valenparamero-crypto/M.A.V.I/diseño mecánico/README.md

# 🔧 Diseño Mecánico — M.A.V.I.

*Módulo Autónomo de Visión Inteligente*

Esta carpeta contiene la documentación del diseño estructural, el modelado CAD tridimensional optimizado, los registros de prototipado rápido y los archivos estandarizados para la fabricación del chasis y los acoples de M.A.V.I.

---

## 📁 Estructura del Área

```text
diseño mecánico/
├── CAD/                                  # Modelos tridimensionales y versiones de diseño
│   ├── v1_inicial/                       # Historial de versiones preliminares
│   │   └── chasis_mavi.stp
│   └── chasis_mavi_modelo_integral_v2.step # Modelo CAD consolidado actual
├── Evidencias/                           # Renders 3D, galería visual y registros de manufactura
│   ├── README.md
│   ├── chasis_mdf_pruebas_fisicas.png
│   ├── proceso_impresion_3d.png
│   ├── soporte_motores.png
│   ├── soportes_rueda_loca_impresos.png
│   ├── vista_isometrica_inferior.png
│   ├── vista_isometrica_superior.png
│   └── DISEÑO CONCEPTUAL CAD CON LISTADO DE MATERIALES.pdf
└── README.md                             # Documentación principal del área
```

---

## ⚙️ Características Mecánicas y de Manufactura

* **Optimización de Chasis:** Reubicación espacial de la batería y rediseño de la distribución interna para mejorar el centro de masa y la estabilidad del robot.
* **Fabricación Aditiva (SLA/FDM):** Impresión 3D en resina y polímeros para soportes personalizados de motorreductores y ruedas locas de balín.
* **Prototipado Físico:** Mecanizado de chasis en MDF para pruebas piloto de validación geométrica, tolerancias y ensamble mecánico preliminar.
* **Sistemas de Tracción:** Acoples adaptados para la integración de ruedas Mecanum orientadas a locomoción omnidireccional.

---

## 👤 Responsables

**Sara Edith Perilla** — Rol: Mecánica  

Formación Integral · Proyecto Integrador I · Proyecto Integrador II · Ingeniería Mecatrónica · Universidad Tecnológica de Pereira · 2026-2
