valenparamero-crypto/M.A.V.I/documentación/README.md

# 📄 Documentación — M.A.V.I.

> *Módulo Autónomo de Visión Inteligente*

Esta carpeta centraliza la documentación formal del proyecto M.A.V.I. Contiene la formulación técnica, la planificación de actividades, los registros de bitácoras y el presupuesto detallado elaborado bajo las normas APA 7ma edición.

---

## 📁 Estructura y Contenido de la Carpeta

```text
documentación/
├── ACTA DE CONSTITUCIÓN.pdf                        # Documento base y acta de inicio del proyecto
├── BITÁCORA DE PLANEACIÓN SEMANA 10 Y 11.pdf         # Planeación de actividades técnicas y administrativas (Semanas 10 y 11)
├── BITÁCORA DE PLANEACIÓN SEMANA 12-13-14.pdf      # Planeación estratégica para las semanas 12 a 14
├── GANTT.xlsx                                      # Cronograma detallado y estimación de carga horaria
├── PLANEACIÓN BITÁCORA SEMANA 8 Y 9.pdf              # Registro preliminar de planeación (Semanas 8 y 9)
├── PLANEACIÓN Y EJECUCIÓN BITÁCORA SEMANA 8 Y 9.pdf  # Bitácora consolidada de planeación y ejecución (Semanas 8 y 9)
├── PLANEACIÓN Y EJECUCIÓN BITÁCORA SEMANA 10 Y 11.pdf  # Bitácora consolidada de planeación y ejecución (Semanas 10 y 11)
├── PROPUESTA FORMAL.pdf                            # Propuesta técnica formal del sistema autónomo
├── README.md                                       # Índice y presentación de la carpeta de documentación
└── Ruta_Critica_CPM.png                            # Diagrama CPM de precedencias, ruta crítica activa y holguras
```  

---

## 👤 Responsable

**Laura Valentina Paramero Lopez** — *Rol: Documentación*  

*Formación Integral · Proyecto Integrador I · Proyecto Integrador II*  
*Ingeniería Mecatrónica · Universidad Tecnológica de Pereira · 2026-2*
