valenparamero-crypto/M.A.V.I/diseño electrónico/Diagrama_De_Bloques_Electrónico.png

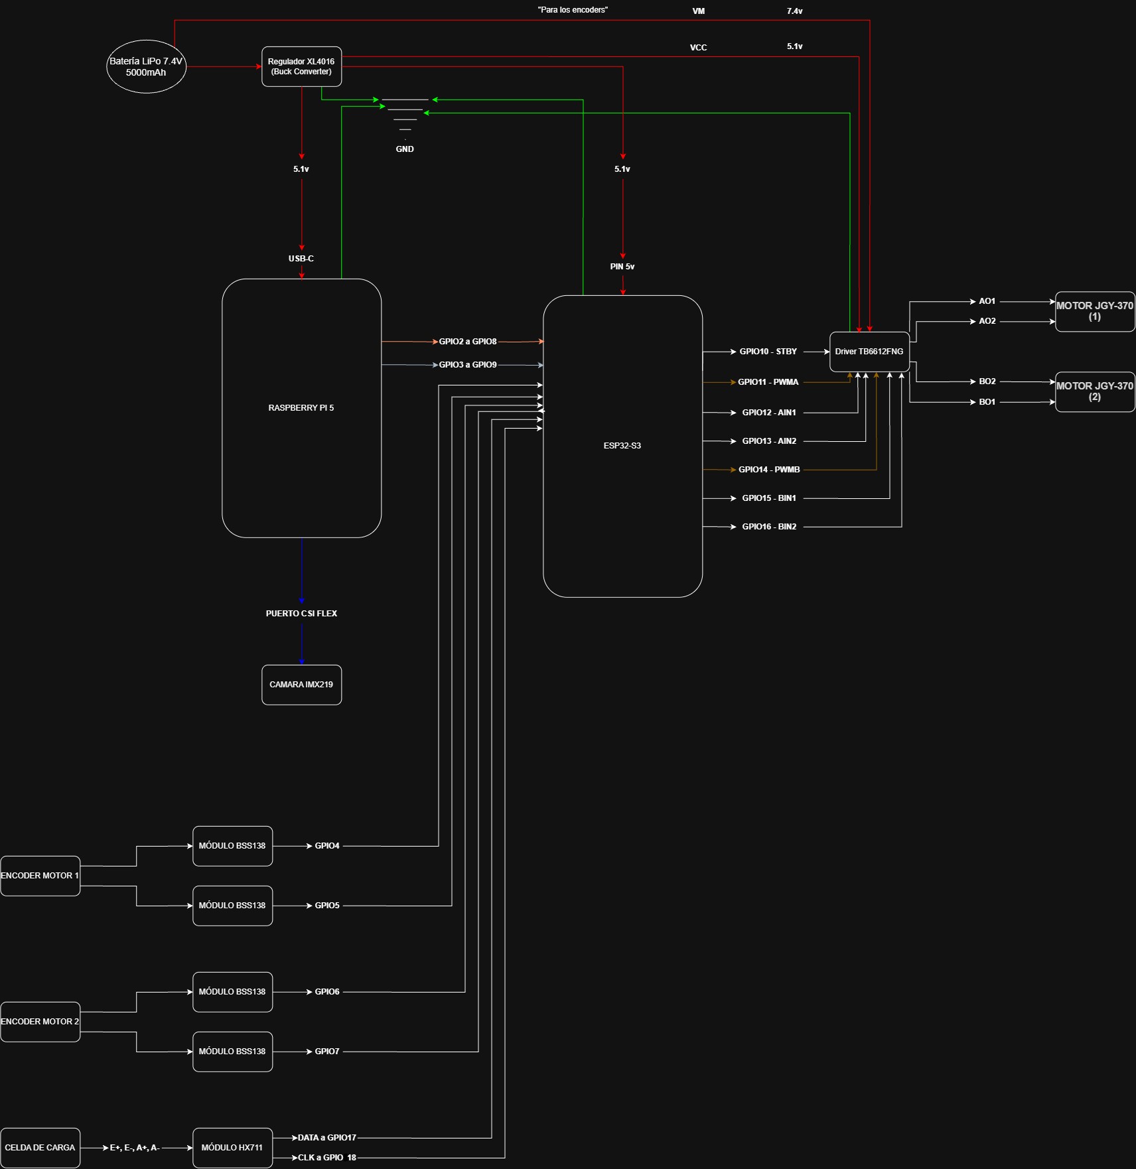
diseño electrónico/Diagrama_De_Bloques_Electrónico.png
