valenparamero-crypto/M.A.V.I/documentación/Ruta_Critica_CPM.png

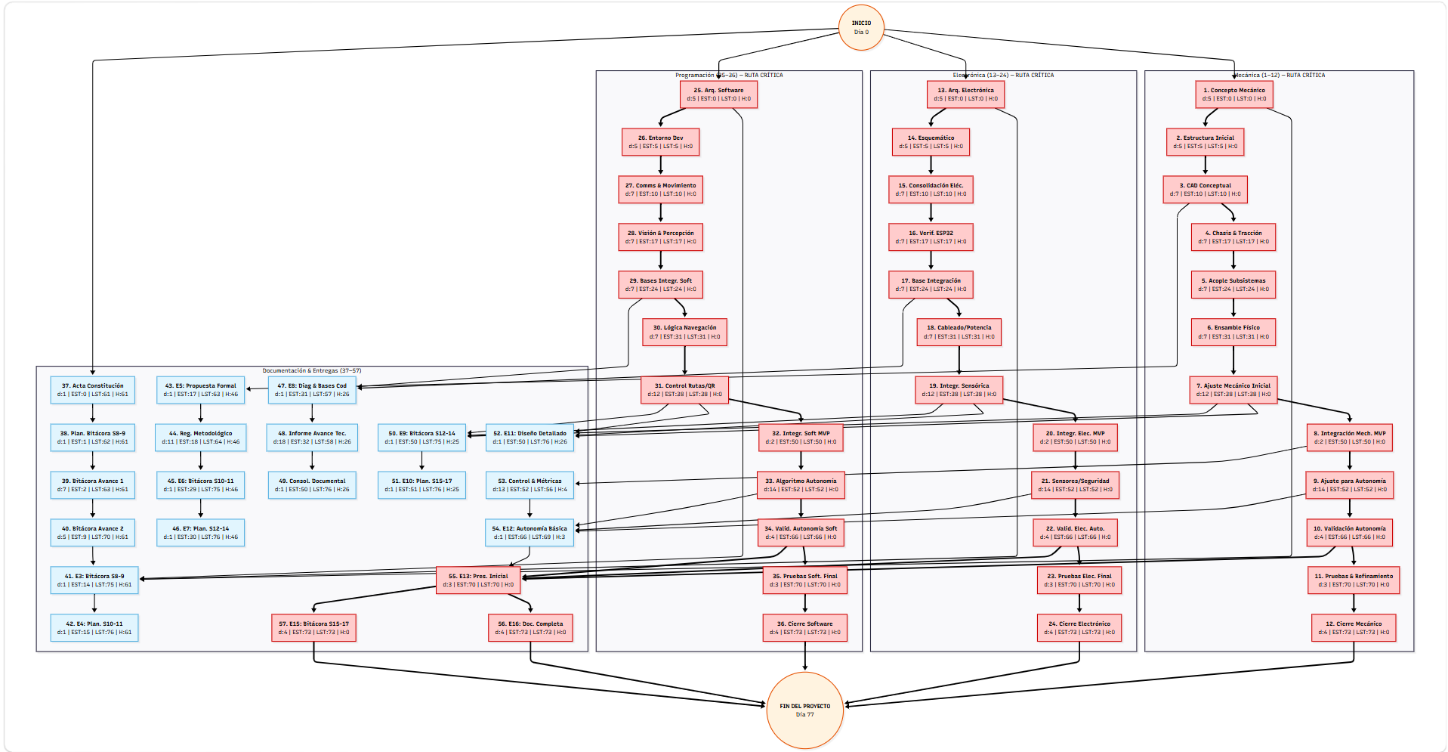
documentación/Ruta_Critica_CPM.png
