valenparamero-crypto/M.A.V.I/diseño mecánico/CAD/chasis_mavi_modelo_integral_v2.step

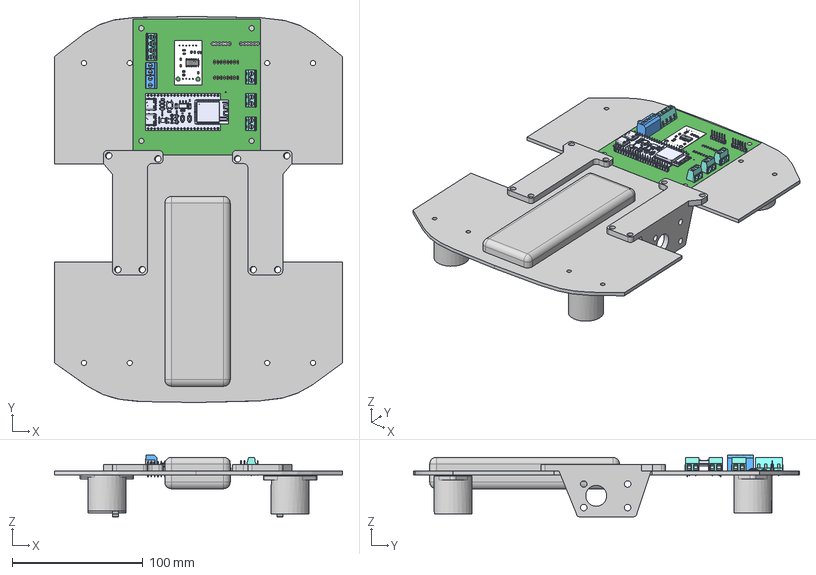
[picture p30: CAD file, 2026-10-15]
diseño mecánico/CAD/chasis_mavi_modelo_integral_v2.step
220.0 x 294.8 x 47.0 mm
BATERIA LiPo TURNIGY 7.4V 5000mAh
