valenparamero-crypto/M.A.V.I/(list of files, cad)

Other CAD files:
diseño mecánico/CAD/v1_inicial/chasis_mavi.stp
diseño electrónico/PCB/mavi_pcb_diseno_integral.f3z
