valenparamero-crypto/M.A.V.I/diseño mecánico/DISEÑO CONCEPTUAL CAD CON LISTADO DE MATERIALES.pdf

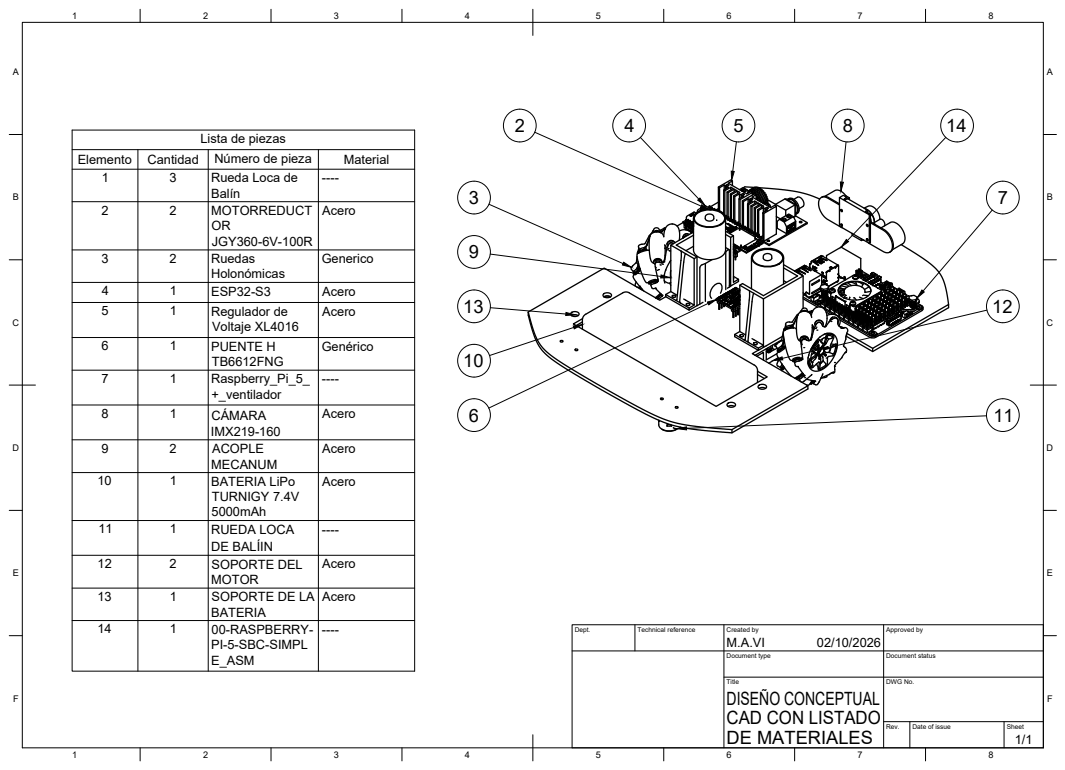
[picture p31: page 1]
Dept.; Technical reference; Created by; Approved by; Document type; Document status; Title; DWG No.; Rev.; Date of issue; Sheet; Elemento; Cantidad; Número de pieza; Material; Rueda Loca de; MOTORREDUCT; Regulador de; Voltaje XL4016; PUENTE H; CÁMARA; BATERIA LiPo; TURNIGY 7.4V; RUEDA LOCA; DE BALÍIN; SOPORTE DEL; SOPORTE DE LA

Lista de piezas

PI-5-SBC-SIMPL
E_ASM

DISEÑO CONCEPTUAL
CAD CON LISTADO
DE MATERIALES
