valenparamero-crypto/M.A.V.I/(commit log)

2026-09-09 Creación de la carpeta de diseño electrónico y de su respectivo README
2026-09-09 Creación de la carpeta de diseño mecánico y de su respectivo README
2026-09-09 Creación de la carpeta de diseño documentación y de su respectivo README
2026-09-10 Actualización del RD de programación
2026-09-10 Actualización del RD de M.A.V.I
2026-09-16 docs: agrega acta de constitución, gantt y ruta crítica
    [GANTT.xlsx]
2026-09-16 Actualización del Readme principal y Readme de documentación
2026-09-16 Cambio de tabla por guia tipo estructura y actualiza nombre completoen Readme de documentación
2026-09-17 Agregar bitácora de planeación semana 8 y 9, actualizacion del RD principal y actualización del RD de documentación
2026-09-25 Crear estructura inicial de src (raspberry, esp32, common)
2026-09-27 Agregar protocol.py con armado y verificacion de mensajes I2C
2026-09-27 Agregar bus I2C simulado y script de prueba del protocolo
2026-09-27 Unificar formato de mensajes en bus_falso
2026-09-27 Agregar acceso real al bus I2C (pendiente de probar con hardware)
2026-09-27 Actualización de RD de M.A.V.I, de src, de common y de raspberry
2026-10-01 Actualización de RD de src
2026-10-01 docs: modularizar README de diseño electronico y crear galeria en evidencias
2026-10-01 corregir nombres de archivos png y enlaces de evidencias
2026-10-01 agregar archivo del chasis en diseño mecanico
    [chasis_mavi.stp]
2026-10-01 Crear carpeta de evidencias y su respectivo rd
2026-10-01 Actualizar rd de diseño mecanico y diseño electronico
2026-10-01 Actualizar evidencias de diseño electrónico
2026-10-01 Actualizar rd de diseño electrónico
2026-10-01 Actualizar rd de documentaciín y agregar bitácora de planeación semana 10 y 11
2026-10-01 Subir documento de planeación y ejecución semana 8 y 9, y actualización de rd de documentación
2026-10-01 Corregir rd de documentación
2026-10-02 Añadir diagrama de bloques y actualizar rd de diseño electrónico
2026-10-03 Agregar diseño cad con lista de materiales
2026-10-15 Actualizar rd de varias carpetas, subir evidenicias
    [chasis_mavi.stp, chasis_mavi_modelo_integral_v2.step, mavi_pcb_diseno_integral.f3z]
2026-10-15 Actualizar rd de documentación y del principal, agregar bitacora de planeación y ejecución semana 10 y 11
2026-10-16 Actualizar rd de evidencias de diseño electronico
2026-10-16 Actualizar rd de diseño electronico
2026-10-16 Agregar en src programa de funcionamiento basico de la camara
2026-10-16 Actualizar rd de la carpeta rpi
2026-10-28 Add files via upload
    Código de avance en la RPI que contiene reconocimiento de AprilTags, Comunicación I2C con ESP32-S3, Telemetría básica RPM, Reconocimiento temprano de pista y Reconocimiento temprano de obstáculos.
2026-10-28 Add files via upload
    Código de avance de ESP32-S3, donde se integra control de motores, lectura de encoders y comunicación I2C con la RPI para que funcione como maquina de estados, donde la ESP32-S3 funciona como "Slave" y la RPI como "Master", controlado remotamente los motores con ordenes hacía la RPI.
2026-11-05 Actualizar rd de la carpeta de evidencias de eldiseño mecanico
